Boomer-54/loconet-pico/loconet-pico/production/bom.csv

Designator | Footprint | Quantity | Value | LCSC Part #
C1 | CP_Radial_D10.0mm_P5.00mm | 1 | 1000µF/16V
C2 | C_Disc_D5.0mm_W2.5mm_P5.00mm | 1 | 100nF
D1 | D_DO-41_SOD81_P7.62mm_Horizontal | 1 | 1N5818
D2 | D_DO-41_SOD81_P10.16mm_Horizontal | 1 | 1N5819
D3 | D_DO-15_P10.16mm_Horizontal | 1 | P6KE18CA
J1, J2 | PinSocket_1x20_P2.54mm_Vertical | 2 | Conn_01x20_Socket
J10, J9 | RJ12_Amphenol_54601-x06_Horizontal | 2 | RJ12
J11 | TerminalBlock_Phoenix_MPT-0,5-2-2.54_1x02_P2.54mm_Horizontal | 1 | Screw_Terminal_01x02
J12 | PinHeader_1x03_P2.54mm_Vertical | 1 | Servo1
J13 | PinHeader_1x03_P2.54mm_Vertical | 1 | Servo2
J14 | PinHeader_1x03_P2.54mm_Vertical | 1 | Servo3
J15 | PinHeader_1x03_P2.54mm_Vertical | 1 | Servo4
J16 | PinHeader_1x03_P2.54mm_Vertical | 1 | Servo5
J17 | PinHeader_1x03_P2.54mm_Vertical | 1 | Servo6
J18 | PinHeader_1x03_P2.54mm_Vertical | 1 | Servo7
J19 | PinHeader_1x03_P2.54mm_Vertical | 1 | Servo8
J20 | PinHeader_1x03_P2.54mm_Vertical | 1 | Servo9
J21 | PinHeader_1x03_P2.54mm_Vertical | 1 | Servo10
J22 | PinHeader_1x03_P2.54mm_Vertical | 1 | Servo11
J23 | PinHeader_1x03_P2.54mm_Vertical | 1 | Servo12
J24 | PinHeader_1x03_P2.54mm_Vertical | 1 | Servo13
J25 | PinHeader_1x03_P2.54mm_Vertical | 1 | Servo14
J26 | PinHeader_1x03_P2.54mm_Vertical | 1 | Servo15
J27 | PinHeader_1x03_P2.54mm_Vertical | 1 | Servo16
J4 | PinHeader_1x18_P2.54mm_Vertical | 1 | Conn_01x18_Pin
Q1 | TO-92_Inline | 1 | BC557
Q2, Q3, Q4 | TO-92_Inline | 3 | BC337
R1 | R_Axial_DIN0207_L6.3mm_D2.5mm_P7.62mm_Horizontal | 1 | 4,7k
R10, R6, R7, R8, R9 | R_Axial_DIN0207_L6.3mm_D2.5mm_P7.62mm_Horizontal | 5 | 10k
R2 | R_Axial_DIN0207_L6.3mm_D2.5mm_P7.62mm_Horizontal | 1 | 1k
R3 | R_Axial_DIN0207_L6.3mm_D2.5mm_P7.62mm_Horizontal | 1 | 47k
R5 | R_Axial_DIN0207_L6.3mm_D2.5mm_P7.62mm_Horizontal | 1 | 2,2k
