Boomer-54/loconet-pico/loconet-pico/loconet-pico.pdf

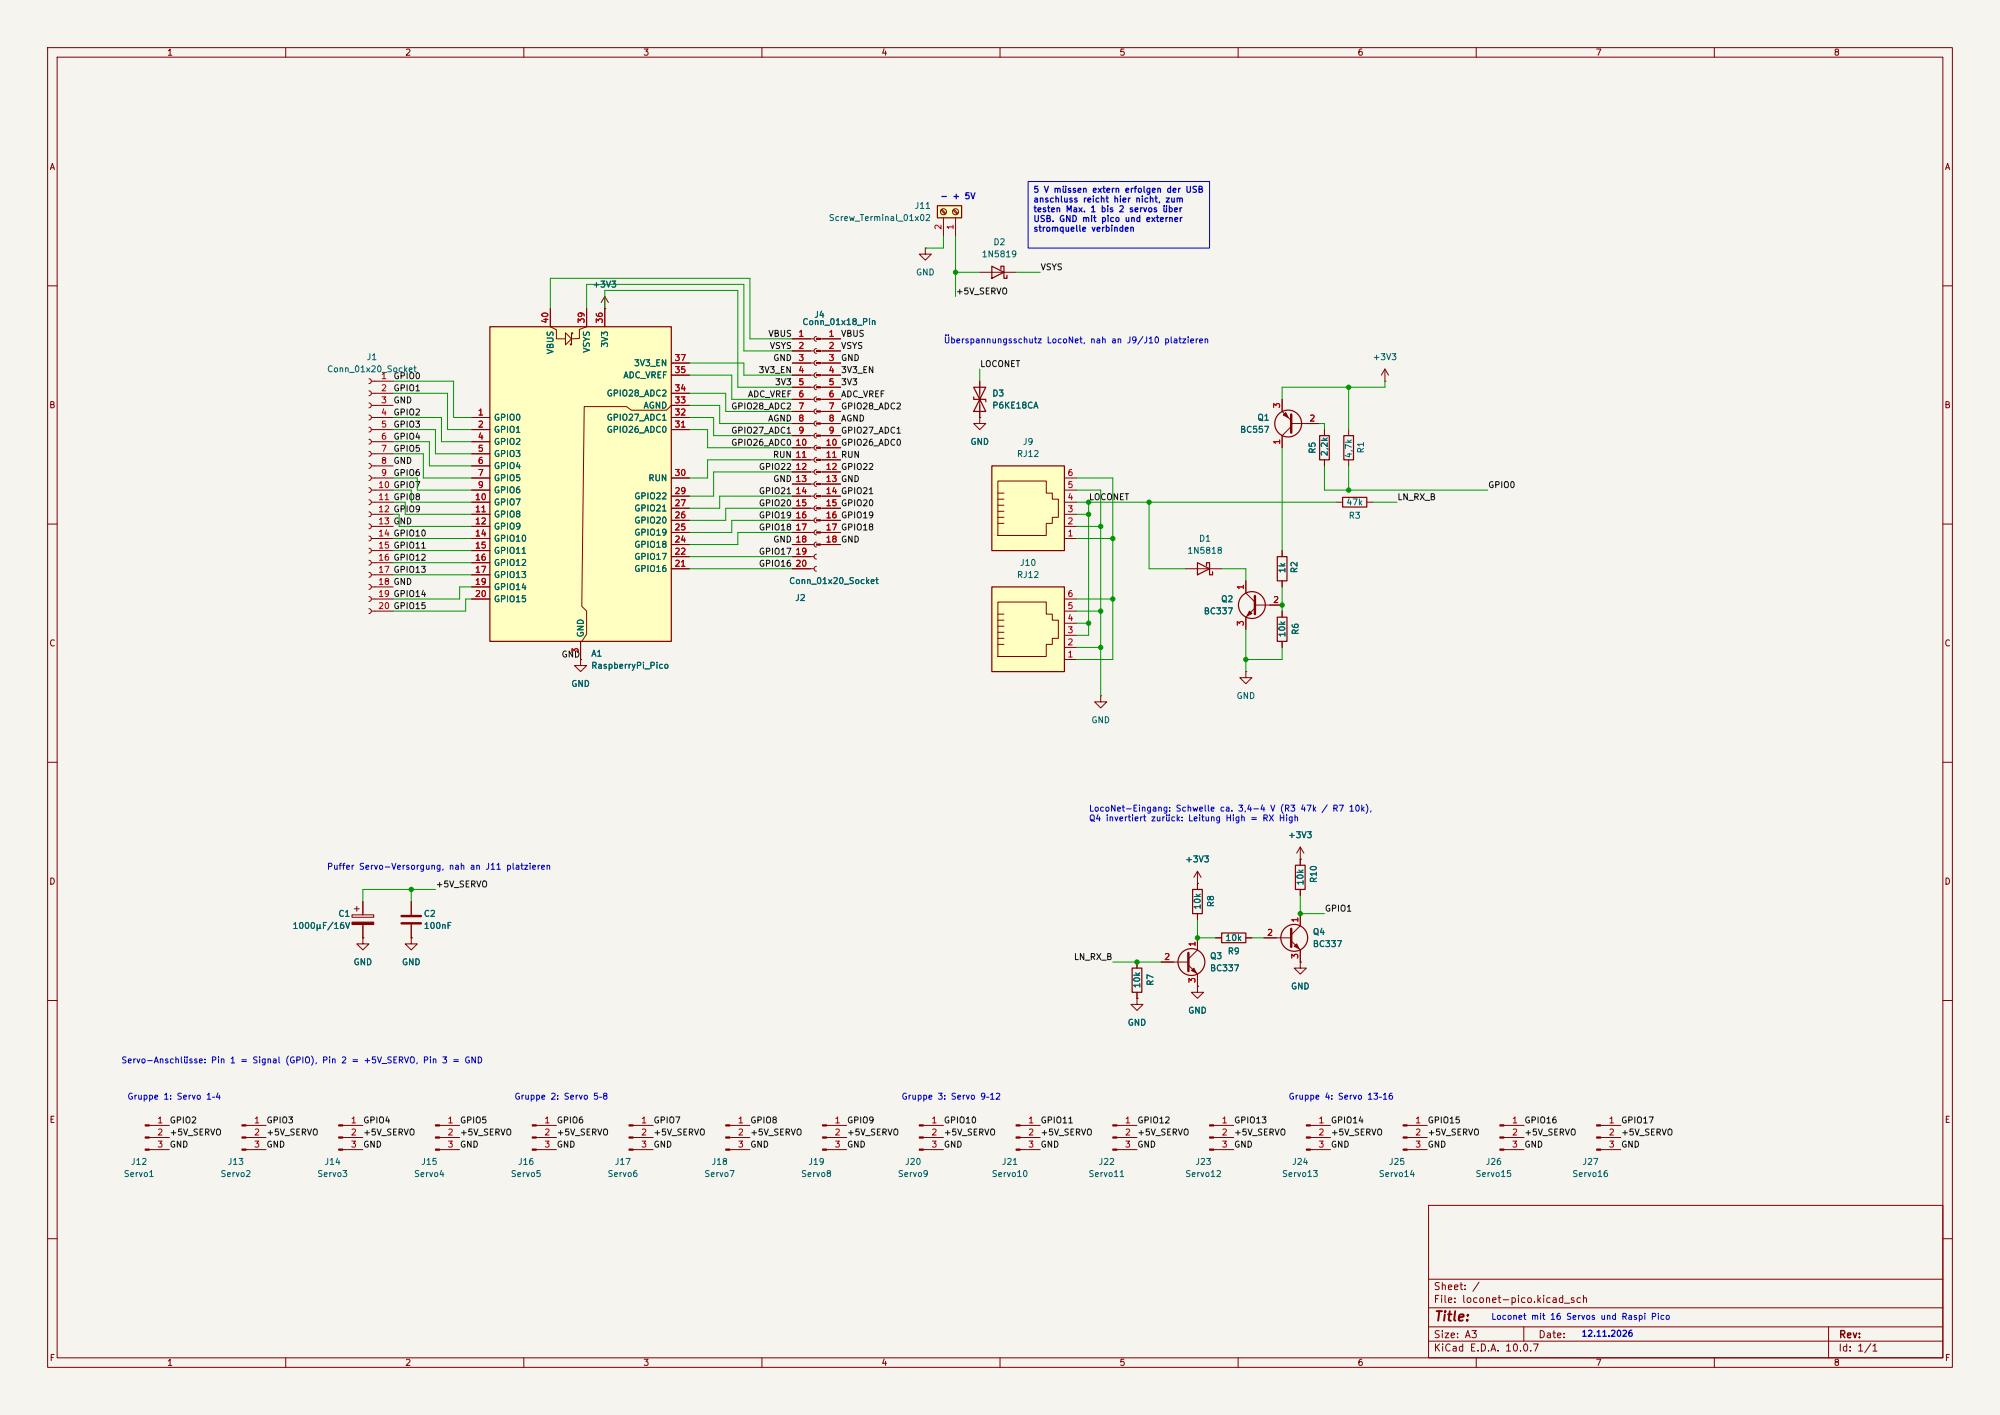
[picture p1: page 1]

- + 5V Überspannungsschutz LocoNet, nah an J9/J10 platzieren

5 V müssen extern erfolgen der USB
anschluss reicht hier nicht, zum
testen Max. 1 bis 2 servos über USB. GND mit pico und externer stromquelle verbinden
J2 Conn_01x20_Socket 1

LocoNet-Eingang: Schwelle ca. 3,4-4 V (R3 47k / R7 10k),

Q4 invertiert zurück: Leitung High = RX High Servo-Anschlüsse: Pin 1 = Signal (GPIO), Pin 2 = +5V_SERVO, Pin 3 = GND

Puffer Servo-Versorgung, nah an J11 platzieren

Loconet mit 16 Servos und Raspi Pico 12.11.2026 Gruppe 3: Servo 9–12

Size: A3 | Rev: | F Date:
KiCad E.D.A. 10.0.7 | Id: 1/1
