Boomer-54/loconet-pico/loconet-pico/loconet-pico.kicad_pcb

## KiCad design loconet-pico/loconet-pico.kicad_pcb (2026-11-13)

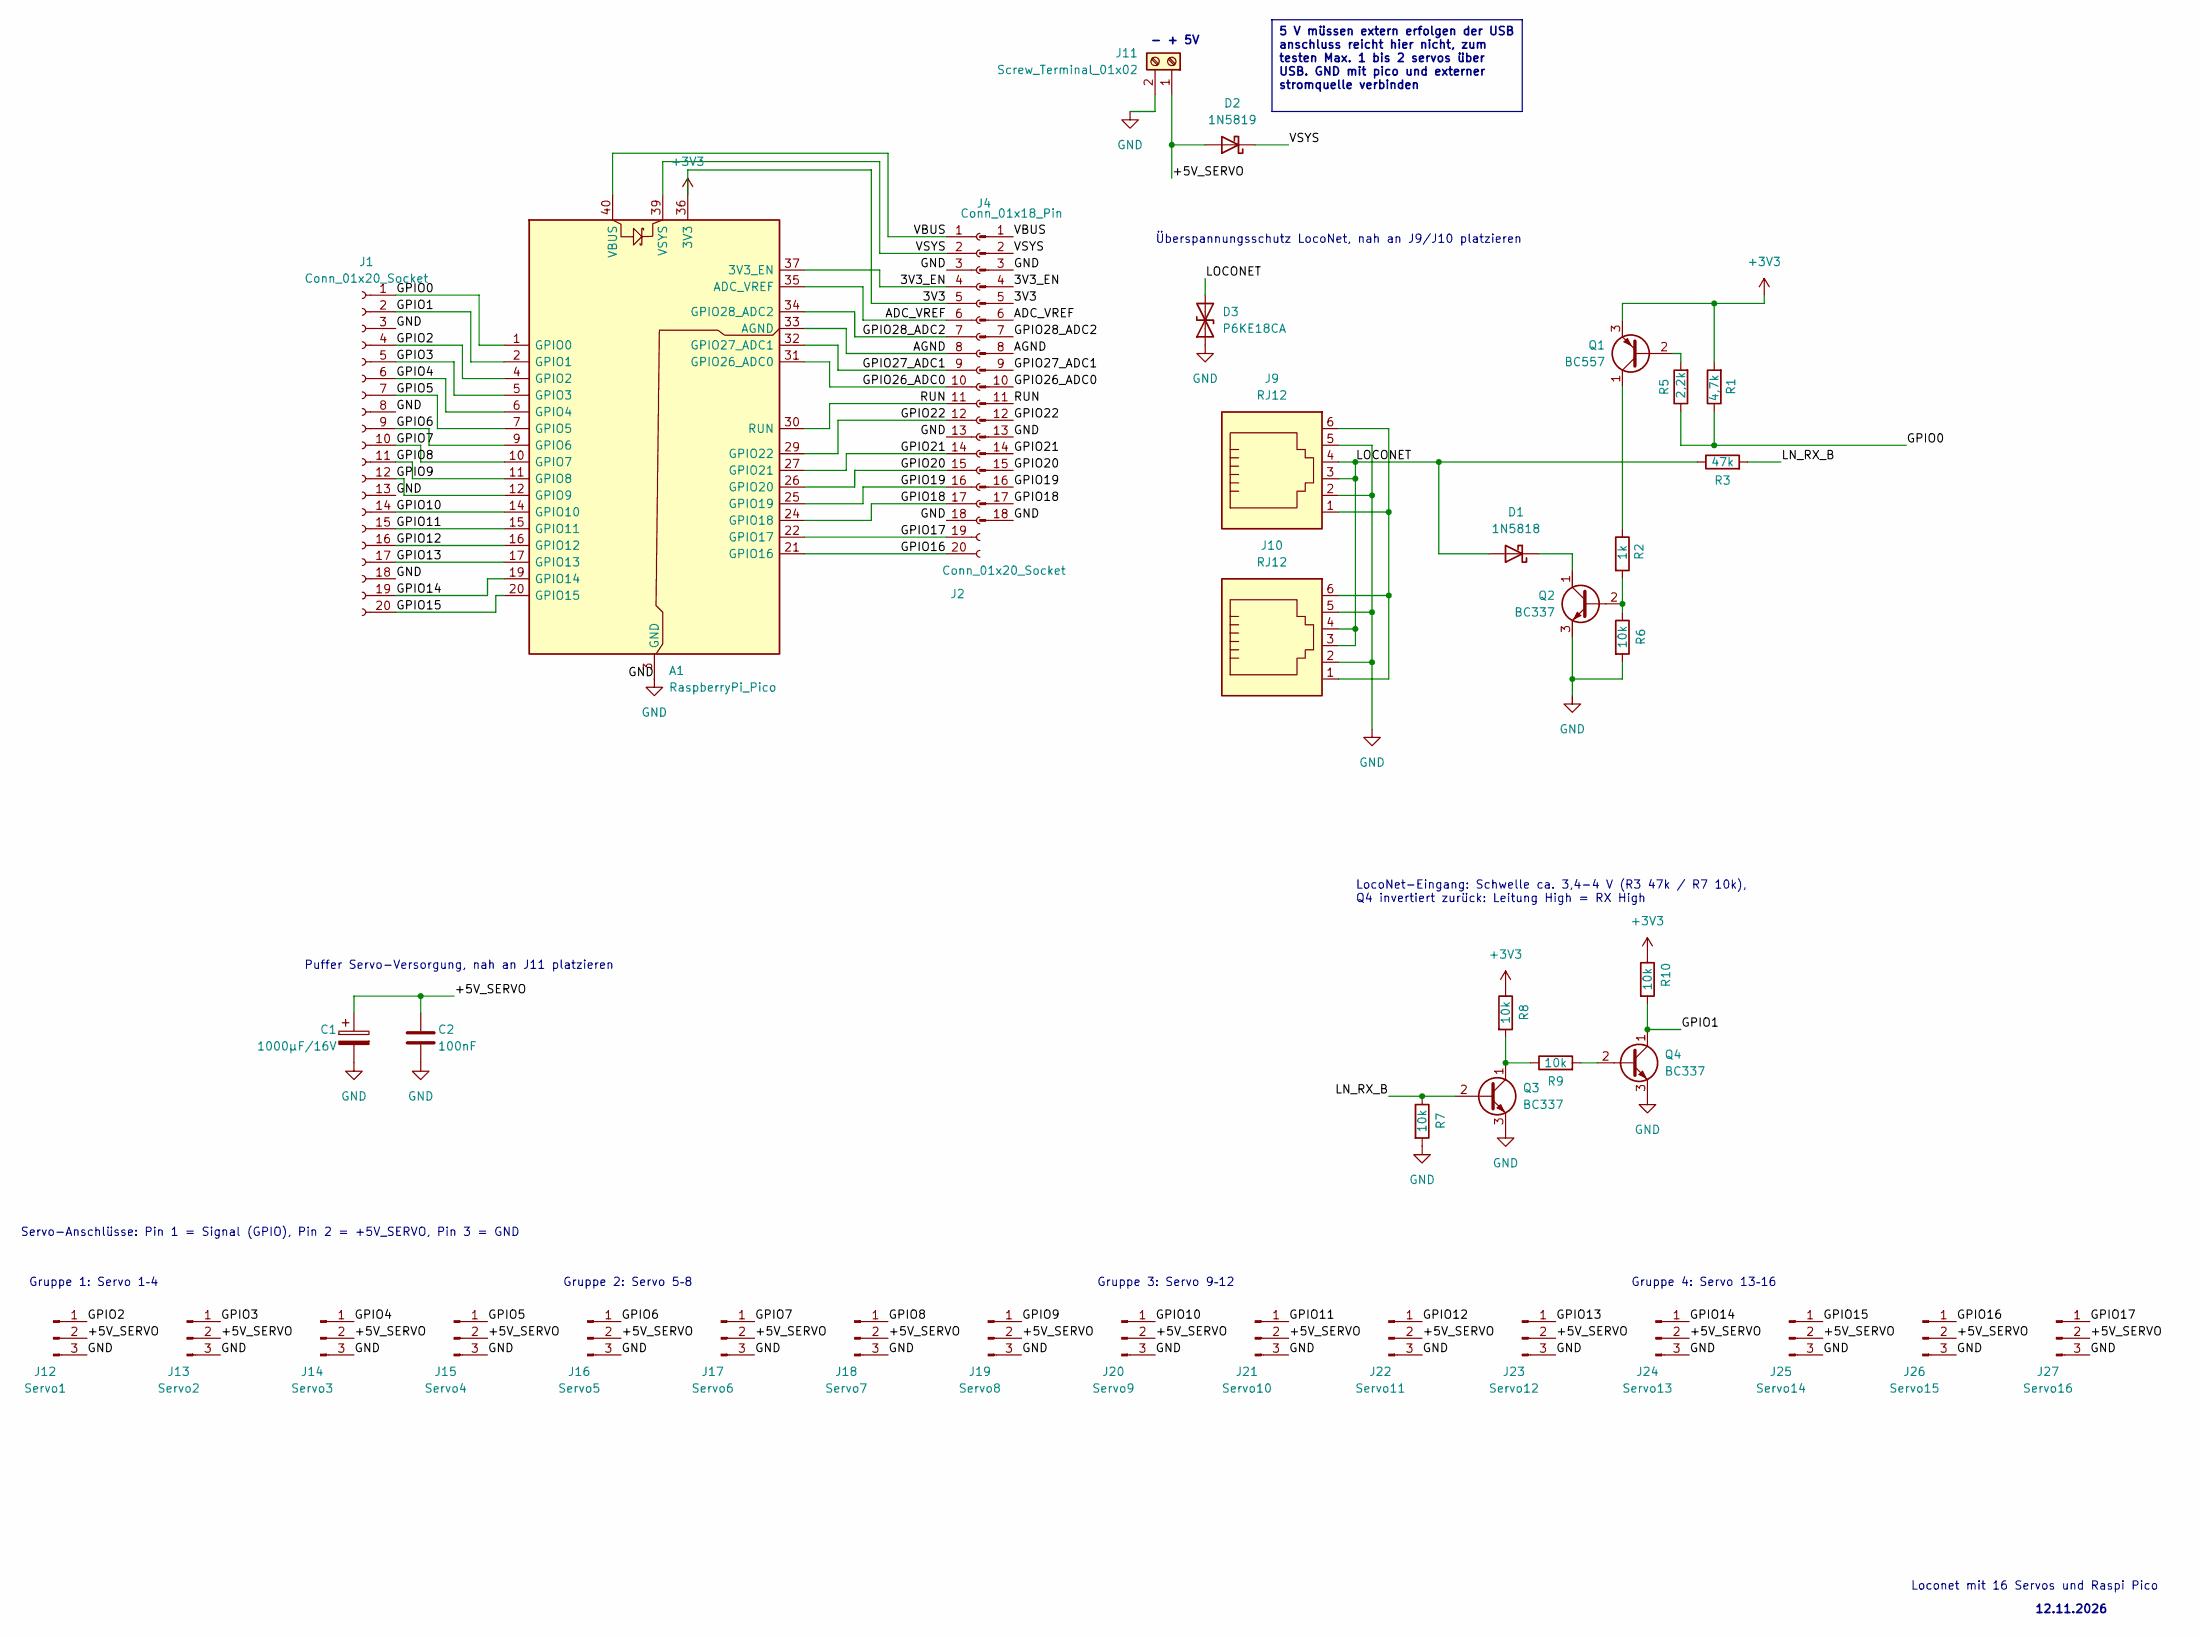
[picture p2: schematic loconet-pico.kicad_sch]

Parts:
A1: RaspberryPi_Pico; RaspberryPi_Pico_Common_Unspecified
C1: 1000µF/16V; CP_Radial_D10.0mm_P5.00mm
C2: 100nF; C_Disc_D5.0mm_W2.5mm_P5.00mm
D1: 1N5818; D_DO-41_SOD81_P7.62mm_Horizontal
D2: 1N5819; D_DO-41_SOD81_P10.16mm_Horizontal
D3: P6KE18CA; D_DO-15_P10.16mm_Horizontal
J1, J2: Conn_01x20_Socket; PinSocket_1x20_P2.54mm_Vertical
J4: Conn_01x18_Pin; PinHeader_1x18_P2.54mm_Vertical
J9, J10: RJ12; RJ12_Amphenol_54601-x06_Horizontal
J11: Screw_Terminal_01x02; TerminalBlock_Phoenix_MPT-0,5-2-2.54_1x02_P2.54mm_Horizontal
J12: Servo1; PinHeader_1x03_P2.54mm_Vertical
J13: Servo2; PinHeader_1x03_P2.54mm_Vertical
J14: Servo3; PinHeader_1x03_P2.54mm_Vertical
J15: Servo4; PinHeader_1x03_P2.54mm_Vertical
J16: Servo5; PinHeader_1x03_P2.54mm_Vertical
J17: Servo6; PinHeader_1x03_P2.54mm_Vertical
J18: Servo7; PinHeader_1x03_P2.54mm_Vertical
J19: Servo8; PinHeader_1x03_P2.54mm_Vertical
J20: Servo9; PinHeader_1x03_P2.54mm_Vertical
J21: Servo10; PinHeader_1x03_P2.54mm_Vertical
J22: Servo11; PinHeader_1x03_P2.54mm_Vertical
J23: Servo12; PinHeader_1x03_P2.54mm_Vertical
J24: Servo13; PinHeader_1x03_P2.54mm_Vertical
J25: Servo14; PinHeader_1x03_P2.54mm_Vertical
J26: Servo15; PinHeader_1x03_P2.54mm_Vertical
J27: Servo16; PinHeader_1x03_P2.54mm_Vertical
Q1: BC557; TO-92_Inline
Q2, Q3, Q4: BC337; TO-92_Inline
R1: 4,7k; R_Axial_DIN0207_L6.3mm_D2.5mm_P7.62mm_Horizontal
R2: 1k; R_Axial_DIN0207_L6.3mm_D2.5mm_P7.62mm_Horizontal
R3: 47k; R_Axial_DIN0207_L6.3mm_D2.5mm_P7.62mm_Horizontal
R5: 2,2k; R_Axial_DIN0207_L6.3mm_D2.5mm_P7.62mm_Horizontal
R6, R7, R8, R9, R10: 10k; R_Axial_DIN0207_L6.3mm_D2.5mm_P7.62mm_Horizontal

Connections:
+3V3: A1.36 (3V3), J2.5, J4.5, Q1.3 (E), R1.2, R8.1, R10.1
/3V3_EN: A1.37 (3V3_EN), J2.4, J4.4
/+5V_SERVO: C1.1, C2.1, D2.2 (A), J11.1, J12.2, J13.2, J14.2, J15.2, J16.2, J17.2, J18.2, J19.2, J20.2, J21.2, J22.2, J23.2, J24.2, J25.2, J26.2, J27.2
/ADC_VREF: A1.35 (ADC_VREF), J2.6, J4.6
/AGND: A1.33 (AGND), J2.8, J4.8
/GPIO0: A1.1 (GPIO0), J1.1, R1.1, R5.1
/GPIO1: A1.2 (GPIO1), J1.2, Q4.1 (C), R10.2
/GPIO2: A1.4 (GPIO2), J1.4, J12.1
/GPIO3: A1.5 (GPIO3), J1.5, J13.1
/GPIO4: A1.6 (GPIO4), J1.6, J14.1
/GPIO5: A1.7 (GPIO5), J1.7, J15.1
/GPIO6: A1.9 (GPIO6), J1.9, J16.1
/GPIO7: A1.10 (GPIO7), J1.10, J17.1
/GPIO8: A1.11 (GPIO8), J1.11, J18.1
/GPIO9: A1.12 (GPIO9), J1.12, J19.1
/GPIO10: A1.14 (GPIO10), J1.14, J20.1
/GPIO11: A1.15 (GPIO11), J1.15, J21.1
/GPIO12: A1.16 (GPIO12), J1.16, J22.1
/GPIO13: A1.17 (GPIO13), J1.17, J23.1
/GPIO14: A1.19 (GPIO14), J1.19, J24.1
/GPIO15: A1.20 (GPIO15), J1.20, J25.1
/GPIO16: A1.21 (GPIO16), J2.20, J26.1
/GPIO17: A1.22 (GPIO17), J2.19, J27.1
/GPIO18: A1.24 (GPIO18), J2.17, J4.17
/GPIO19: A1.25 (GPIO19), J2.16, J4.16
/GPIO20: A1.26 (GPIO20), J2.15, J4.15
/GPIO21: A1.27 (GPIO21), J2.14, J4.14
/GPIO22: A1.29 (GPIO22), J2.12, J4.12
/GPIO26_ADC0: A1.31 (GPIO26_ADC0), J2.10, J4.10
/GPIO27_ADC1: A1.32 (GPIO27_ADC1), J2.9, J4.9
/GPIO28_ADC2: A1.34 (GPIO28_ADC2), J2.7, J4.7
/LN_RX_B: Q3.2 (B), R3.2, R7.1
/LOCONET: D1.2 (A), D3.2 (A2), J9.3, J9.4, J10.3, J10.4, R3.1
/RUN: A1.30 (RUN), J2.11, J4.11
/VBUS: A1.40 (VBUS), J2.1, J4.1
/VSYS: A1.39 (VSYS), D2.1 (K), J2.2, J4.2
GND: A1.3 (GND), A1.8 (GND), A1.13 (GND), A1.18 (GND), A1.23 (GND), A1.28 (GND), A1.38 (GND), C1.2, C2.2, D3.1 (A1), J1.3, J1.8, J1.13, J1.18, J2.3, J2.13, J2.18, J4.3, J4.13, J4.18, J9.2, J9.5, J10.2, J10.5, J11.2, J12.3, J13.3, J14.3, J15.3, J16.3, J17.3, J18.3, J19.3, J20.3, J21.3, J22.3, J23.3, J24.3, J25.3, J26.3, J27.3, Q2.3 (E), Q3.3 (E), Q4.3 (E), R6.2, R7.2
unnamed: D1.1 (K), Q2.1 (C)
unnamed: J9.1, J9.6, J10.1, J10.6
unnamed: Q1.2 (B), R5.2
unnamed: Q1.1 (C), R2.1
unnamed: Q2.2 (B), R2.2, R6.1
unnamed: Q3.1 (C), R8.2, R9.1
unnamed: Q4.2 (B), R9.2

Notes on the sheet:
LocoNet-Eingang: Schwelle ca. 3,4-4 V (R3 47k / R7 10k), Q4 invertiert zurück: Leitung High = RX High
Loconet mit 16 Servos und Raspi Pico
Gruppe 1: Servo 1–4
Gruppe 3: Servo 9–12
Gruppe 2: Servo 5–8
Gruppe 4: Servo 13–16
Servo-Anschlüsse: Pin 1 = Signal (GPIO), Pin 2 = +5V_SERVO, Pin 3 = GND
Überspannungsschutz LocoNet, nah an J9/J10 platzieren
Puffer Servo-Versorgung, nah an J11 platzieren
- + 5V
12.11.2026
5 V müssen extern erfolgen der USB anschluss reicht hier nicht, zum testen Max. 1 bis 2 servos über USB. GND mit pico und externer stromquelle verbinden

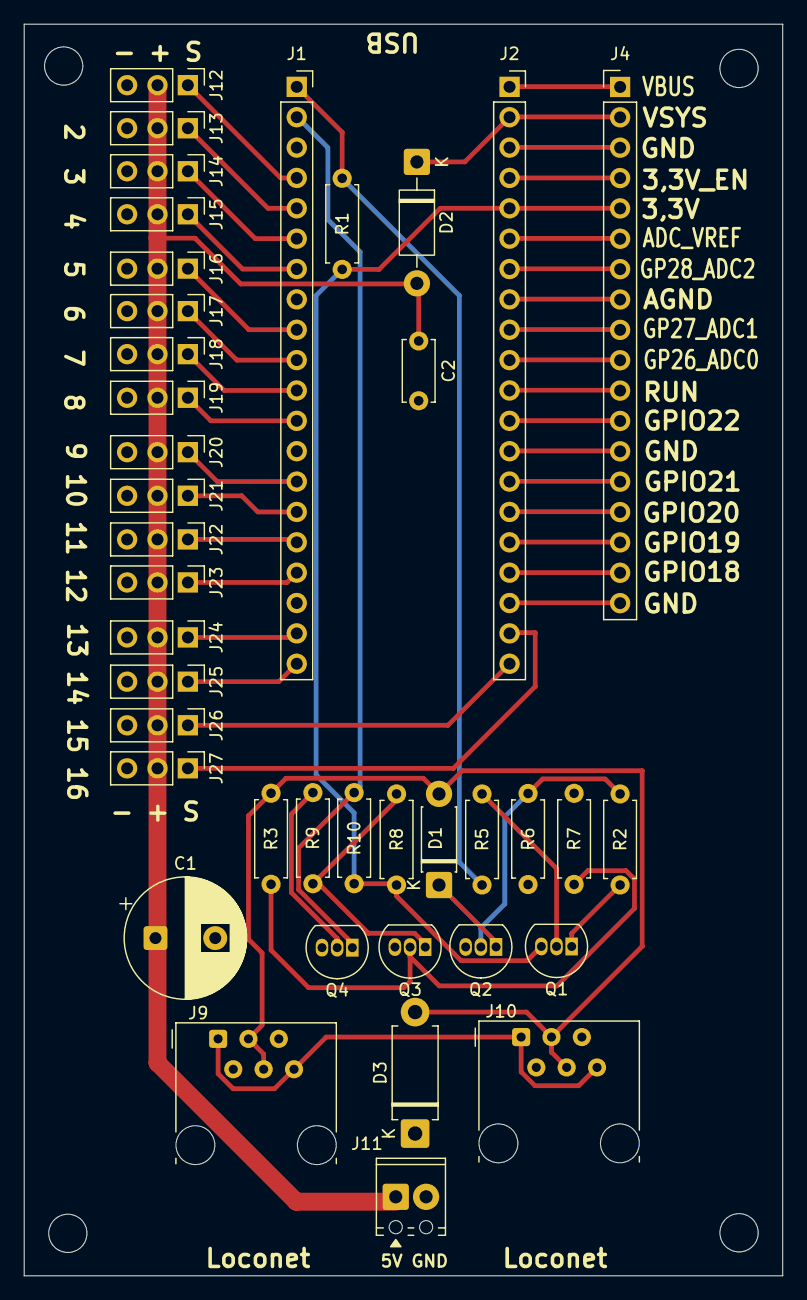
[picture p3: board loconet-pico.kicad_pcb from above]

Board: 2 copper layers, 63.4 x 104.7 mm, 44 parts (0 on the bottom side), 44 nets.

Other parts of the board:
H1, H2, H3, H4: MountingHole_3.2mm_M3
