Boomer-54/loconet-pico/(commit log)

2026-11-12 LocoNet-Pico: Interface und Servoboard für 16 Servos
    - Hauptprojekt: LocoNet-Interface mit Zwei-Transistor-Stufen für TX und RX
    - Unterprojekt loconet-pico: Servodecoder mit gesockeltem Raspberry Pi Pico,
    16 Servo-Anschlüssen, 5-V-Klemme, Puffer-Elko und TVS-Schutz
    - production: Fertigungsdaten für JLCPCB
    [bom.csv, designators.csv, loconet-pico-v2.kicad_sch, loconet-pico.kicad_pcb, loconet-pico.kicad_sch, positions.csv]
2026-11-13 Schaltplan-PDF aus aktuellem Stand neu exportiert
    Zeigt jetzt die Transistor-Eingangsstufe (R3 47k, Q3/Q4) statt des
    alten Spannungsteilers am LocoNet-Empfang.
2026-11-13 Altes Interface-Projekt entfernt, Servoboard-PDF und README ergänzt
    Im Hauptordner lag noch das ältere Interface-Board mit Spannungsteiler
    am LocoNet-Empfang. Gültig ist nur noch das Servoboard in loconet-pico/
    mit Transistor-Eingangsstufe (R3 47k, Q3/Q4) und TVS-Schutz.
    [loconet-pico-v2.kicad_sch, loconet-pico.kicad_pcb, loconet-pico.kicad_sch]
2026-11-13 LocoNet-Empfang: R7 auf 10k, Schwelle unter 4 V
    Mit R3 47k / R7 10k liegt die Schaltschwelle bei ca. 3,4–4 V, sodass
    logisch 1 ab 4 V sicher erkannt wird. Hinweistext, PDF und README
    angepasst. Platine und BOM werden noch in KiCad nachgezogen.
    [loconet-pico.kicad_sch]
2026-11-13 Platine und Fertigungsdaten mit R7 10k aktualisiert
    [bom.csv, loconet-pico.kicad_pcb]
